ut-robotics/picr21-team-kobe/Kobe_Elektronics/Driver_footprint_w_desc.png

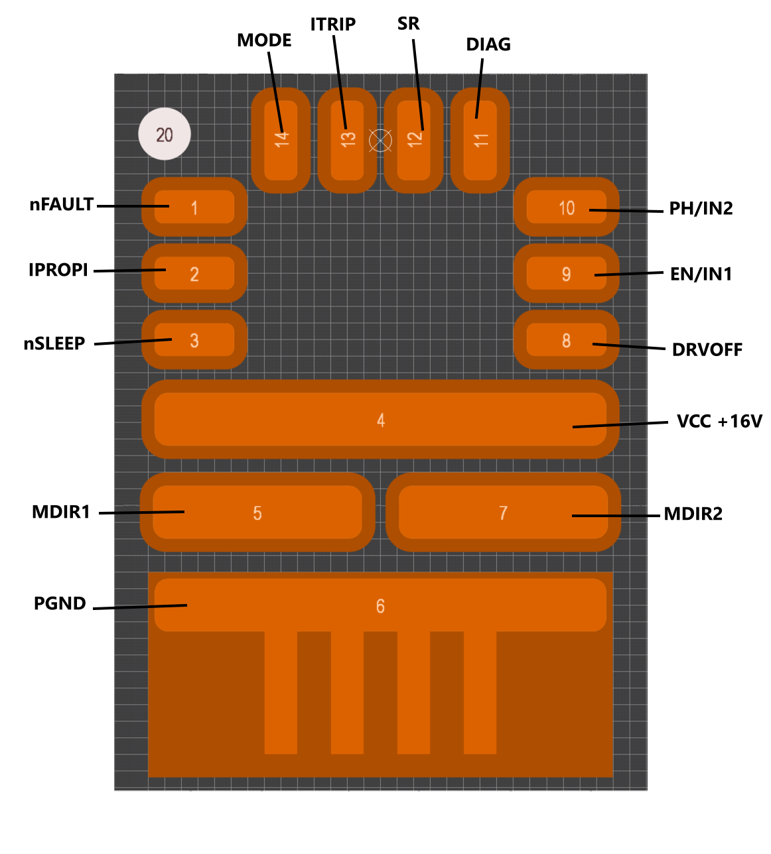
Kobe_Elektronics/Driver_footprint_w_desc.png
