ut-robotics/picr21-team-kobe/Kobe_Elektronics/BOM_PartType-Kobe_BasketballRobot.xlsx

Comment | Description | Designator | Quantity | Farnell | Mouser | TME
100nF |  | C1, C2, C3, C4, C5, C10, C12, C13, C14, C15, C16, C18, C19, C20, C21 | 15
10uF | Capacitor 1206 | C6, C7, C8, C17, C23, C25, C26, C27, C28 | 9
1uF |  | C9, C11, C22, C24 | 4
CM1223 | TVS diode, USB | D1 | 1 | 3607672 (https://uk.farnell.com/on-semiconductor/cm1223-02so/esd-protection-devices/dp/3607672) | 748-CM1223-02SO (https://eu.mouser.com/ProductDetail/onsemi/CM1223-02SO?qs=lLuKAerq7nnvVg3rEtIojA%3D%3D)
LED red |  | D2, D3, D4, D5 | 4
MicroUSB_K | microUSB port | J1 | 1
37D motor | Wheel motor | J2, J3, J4 | 3
ST-LINK | Programmer for microcontroller | J7 | 1 |  | 200-FTSH10501LDVK (https://eu.mouser.com/ProductDetail/Samtec/FTSH-105-01-L-DV-K?qs=%252B5JSS813miOqo3Vy%252BvhCFg%3D%3D)
Encoder | Encoder for motor | J8, J9, J10 | 3 |  |  | AMP-7-215079-4 (https://www.tme.eu/en/details/amp-7-215079-4/micro-match-connectors-1-27mm/te-connectivity/215079-4/)
Thrower | Thrower motor | J11 | 1 |  |  | AMP-7-215079-4 (https://www.tme.eu/en/details/amp-7-215079-4/micro-match-connectors-1-27mm/te-connectivity/215079-4/)
4,7k |  | R1, R3, R4, R7 | 4
3,3k |  | R2, R5, R6 | 3
100k |  | R9, R13, R17 | 3
BUK6Y10-30P | Reverse voltage protection | T1 | 1 | 3438512 (https://ie.farnell.com/nexperia/buk6y10-30px/mosfet-p-ch-30v-80a-lfpak56/dp/3438512) | 771-BUK6Y10-30PX (https://eu.mouser.com/ProductDetail/Nexperia/BUK6Y10-30PX?qs=vmHwEFxEFR9UKLhknfc3PQ%3D%3D)
DRV8243H-Q1 | Motor driver | U1, U2, U3 | 3 |  |  |  | DRV8243-Q1 (https://www.ti.com/product/DRV8243-Q1)
STM32G441 | Microcontroller | U4 | 1 | 3132405 (https://ee.farnell.com/stmicroelectronics/stm32g431kbt6/mcu-32bit-170mhz-lqfp-32/dp/3132405) | 511-STM32G431KBT6 (https://www.mouser.ee/ProductDetail/STMicroelectronics/STM32G431KBT6?qs=T3oQrply3y8teCTeNAFOLg%3D%3D)
MAX14930 | 4 channel isolator | U5, U8 | 2 | 3257451 (https://ie.farnell.com/maxim-integrated-products/max14930dase/digital-isolator-4ch-40-to-125deg/dp/3257451) | 700-MAX14930DASE+ (https://eu.mouser.com/ProductDetail/Maxim-Integrated/MAX14930DASE+?qs=AAveGqk956HveTQGChomNg%3D%3D)
NCP164 | TSOP-5 microcontroller voltage regulator | U6 | 1 | 3367831 (https://ee.farnell.com/on-semiconductor/ncp164csn330t1g/ldo-fixed-3-3v-0-3a-40-to-150deg/dp/3367831) | 863-NCP164CSN330T1G (https://eu.mouser.com/ProductDetail/onsemi/NCP164CSN330T1G?qs=xZ%2FP%252Ba9zWqbi%2FAyy5UtoRw%3D%3D)
NCV8730 | TSOP-5 Voltage regulator motor driver | U9 | 1 | 3463974 (https://il.farnell.com/on-semiconductor/ncv8730asn500t1g/ldo-fixed-5v-0-15a-40-to-125deg/dp/3463974) | 863-NCV8730ASN500T1G (https://eu.mouser.com/ProductDetail/onsemi/NCV8730ASN500T1G?qs=GedFDFLaBXHk1ABQHGw1TA%3D%3D)
