ut-robotics/picr21-team-kobe/(threads)

Thread 1 (2021-09-23):

[Mechanics] - sketches underdefined

Akustav, 2021-09-23:
Sketches for components are underdefined. This creates issues when you need to change model dimensions and the component can react in unexpected ways.
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
Can be changed to something like this without issues. It certainly is invalid
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

Also:
The warnings in components should not be ignored but fixed:
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

This feedback goes for all components you created.

erkiveevali, 2021-09-28:
Resolved the warnings, fixed underdefined sketches where I could find them.

Akustav, 2021-09-28:
Seems fine now.

Closed 2021-09-28.

Thread 2 (2021-09-23):

[Mechanics] - material thickness is wrong

Akustav, 2021-09-23:
The 5 mm material is in reality 4.8. All components should use this thickness instead of 5.0mm. If you want to use 3 mm PC then the thickness for that is 2.8mm.

erkiveevali, 2021-09-28:
Thrower components (sidewalls and ramps) are now 4.8mm thick. Motor spacer however needs to be 8mm thick for the motor to be positioned in the center of the thrower, so this needs to be 3D-printed I think.

Akustav, 2021-09-28:
Okay. Seems fine.

Closed 2021-09-28.

Thread 3 (2021-09-23):

[Mechanics] - spacers in thrower can be touched by ball

Akustav, 2021-09-23:
Spacers inside the thrower might be too close to the ramps outside edge and can collide with the ball
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

erkiveevali, 2021-09-28:
The spacers are only between the sidewalls and ramps and not in the wide gap in the center(where the ball would be pushed into the most). Is the ball really gonna be pushed into the thin (7.5mm) gap between on the sides. Also if the ball is compressed on the motor side as well, it won't reach to the spacers.

I could move the spacers further back but I'm afraid that the construction wouldnt be as strong then, if the screw holes are just a couple millimeters from the edge. Another solution would be to move the motor further to front a bit.

Is the gap between the ramps and motor OK right now? If I am gonna need to move components around a bit, then I can change these parameters as well if needed.

Akustav, 2021-09-28:
Okay, true.

Closed 2021-09-28.

Thread 4 (2021-09-23):

[Mechanics] - thrower cable hole seems too small

Akustav, 2021-09-23:
Is the hole for motor cables sized correctly to fit the cables through?

erkiveevali, 2021-09-28:
Made the hole a bit bigger so cables certainly fit through.

Closed 2021-09-28.

Thread 5 (2021-09-23):

[Mechanics] - inteference in the assembly

Akustav, 2021-09-23:
There are clipping parts in the assembly that should be looked at. I suspect there is additional interference around the circled areas on the picture. Usually, there should be no interference.
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

erkiveevali, 2021-09-28:
Since I changed the components and joints due to other issues then those interference problems should be resolved as well. Fusion  still shows some interference in the assembly, but I'm not entirely sure why.

Akustav, 2021-09-28:
I suggest checking how these 4 corners are cut in the actual model:

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

There might be some radiuses that are not accounted for in the design but are there due to milling

erkiveevali, 2021-09-30:
The top ones are fine, since the sides of the ramps arent touching the plate and the corners of the hole in the plate aren't sharp 90degree angles.
On the bottom plate however, the angles do have a small radius that isnt present on the model. I'd say I just file the corners on the bottom plate a bit, to make the ramps fit snugly right against the bottom plate. Thats because I'd like the ramps to be supported by the plate like that.

Akustav, 2021-09-30:
This issue is then OK. You can continue with the CAM

Closed 2021-09-30.

Thread 6 (2021-09-23):

[Mechanics] - robot height from the ground

Akustav, 2021-09-23:
How high should the robot be off the ground with its wheels? It is important as it affects how high the motor can be. If it is too high, the ball won't be pulled in and instead bounces off other parts of the chassis. This also allows tuning how low the ramp can be without damaging the carpet or disturbing the robots driving

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

erkiveevali, 2021-09-28:
The bottom plate is around 8mm off the ground right now. The thrower ramp extends 5.5mm from the bottom plate - there should be 2.5mm of clearance between the carpet and the thrower ramps.

Akustav, 2021-09-28:
Okay, if it is 8mm then everything seems fine.

Closed 2021-09-28.

Thread 7 (2021-10-07):

[Mechanics] - current feedrates too large

Akustav, 2021-10-07:
I think the current state of the mill does not allow for 1000mm/min feedrates. I would suggest at most 800mm. You can also reduce RPM to around 16000 in this case.

Closed 2021-10-07.

Thread 10 (2021-10-10):

with serial errors the connection is closed

Akustav, 2021-10-10:
https://github.com/ut-robotics/picr21-team-kobe/blob/46eb101d32f8b6000470f36c38c8d0c5126a2891/serialcomms.py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

With how this currently is the serial connection is shut down and no feedback is relayed to the program. It would be much preferred to throw an exception that can be handled and maybe the serial connection can be re-established.

Akustav, 2021-10-17:
The current solution currently prints an error, so you can see it in the log but it is unusable in the logic since the method itself does not throw an exception.
`raise Exception("some exception text")`
can be used for that.

Closed 2021-10-21.

Thread 12 (2021-10-10):

finding and driving to ball are separate files with alot of duplicate code

Akustav, 2021-10-10:
All tasks in programming are iterative and should not be considered as separate. Currently the code is structured so that every task is separate and isolated (Find_Detect.py and Find_Drive.py).

Maybe I am looking at wrong files but how things should be structured is that you have a file or collection of files that drive some kind of a state machine that does the decisions like finding balls, aiming, throwing, etc. This kind of structure allows for better logical separation and simplifies debugging since certain parts of code are responsible for well defined functionalities.

**NOTE: this is a example structure and should not be taken as pure gold. It illustrates how to write more maintainable code**

A example structure:
* robot_runner.py - main file containing the state machine and contains game logic/decision making components. Should not directly utilize low logic components like mainboard_communication.py but instead robot_driver.py. Same for camera.
* referee_module.py - module with methods for handling the web-socket data sent by the referee module.
* camera_module.py - base methods to fetch frames from the camera and to configure its parameters.
* image_processing.py - contains logic that handles vision, like getting ball/basket coordinates, has abstraction methods to simplify handling of visual data
* mainboard_communication.py - contains info on how to send and receive commands to/from the mainboard
* robot_driver.py - used as a abstraction layer between the mainboard_communication.py and robot_runner.py. Exposes methods to dictate how the robot should drive using omni-motion (speed, direction, rotation, etc), and to control the throwing mechanism.
* camera_calibration.py - uses the image processing.py and provides an UI to calibrate colors for the robot. Generates the configuration used by image_processing.py

Thread 17 (2021-10-10):

hardcoded frame width

Akustav, 2021-10-10:
https://github.com/ut-robotics/picr21-team-kobe/blob/46eb101d32f8b6000470f36c38c8d0c5126a2891/Find_Drive.py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

The way this is currently solved it is impossible to change camera resolution without extensive changes required in the driving logic. I would suggest having these sizes in a configuration file and rather use percentages than hardcoded constants unless they are based on constants, like speeds (m/s definition does not change, for example).

Akustav, 2021-10-17:
Seems better now, yeah

Closed 2021-10-17.

Thread 22 (2021-10-21):

[Mechanics] tweaks to the way rollers are held in by the wheel

Akustav, 2021-10-21:
I would suggest 3 changes to the wheel roller area.
1. Tighten tolerances to the shaft of the roller, you can leave around 0.1mm or so
2. Add more space to the roller area. This reduces roller resistance and dirt affects driving less. I would suggest 0.3-0.5mm per side for spacing
3. To counteract the larger spacing per roller you can add a conical support to where the shaft connects to the roller. This reduces roller wobble.

Summary picture:
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

Akustav, 2021-11-01:
OK now

Closed 2021-11-01.

Thread 24 (2021-10-21):

[Mechanics] - reduce size of fastener

Akustav, 2021-10-21:
I would reduce the size of the motor fastener piece. This makes your life easier since there is less material to remove.

An example of D=30mm vs D=25mm:

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

I think you can also make it shorter:

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

Akustav, 2021-11-01:
OK

Closed 2021-11-01.

Thread 29 (2021-11-06):

Refactor states to use enums and matcher

Akustav, 2021-11-06:
An example of how enums can be defined and used in the driving logic instead of a IF-ELSE block:

```
from enum import Enum
class State(Enum):
 FIND = 0
 DRIVE = 1
 AIM = 2
 THROW = 4
```

If you use python 10 you can also use this:
```
while True:
 ...
 match state:
  case FIND:
   ...
   continue
  case DRIVE:
   ...
   continue
  ...
```

Before python 10 you can utilize this example. It is limited in the sense that fall through is a pain

```
from enum import Enum

class State(Enum):
 FIND = 0
 DRIVE = 1
 AIM = 2
 THROW = 3

def handleFind(coordinates):
    print("finding_" + str(coordinates))

def handleDrive(coordinates):
    print("driving_" + str(coordinates))

ballData = ["someData"]

switcher={
    State.FIND: handleFind(ballData),
    State.DRIVE: handleDrive(ballData)
    }

# main loop that executes some logic
switcher.get(State.FIND)
switcher.get(State.DRIVE)
```

https://github.com/ut-robotics/picr21-team-kobe/blob/9f3d25f5802e43e8fc130219fb4fb0fc0b259346/Robot_runner.py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

capnarchie, 2021-11-07:
Is this the correct implementation?
https://github.com/ut-robotics/picr21-team-kobe/blob/f1049b4e73890cd247a7a22e3b0cb84c8893d68e/Robot_runner.py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
https://github.com/ut-robotics/picr21-team-kobe/blob/f1049b4e73890cd247a7a22e3b0cb84c8893d68e/Robot_runner.py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
https://github.com/ut-robotics/picr21-team-kobe/blob/f1049b4e73890cd247a7a22e3b0cb84c8893d68e/Robot_runner.py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

Although I don't see the real difference in this implementation, I'm still using if statements too, or did I misunderstand something?

Akustav, 2021-11-07:
I would use State.FIND instead of State(0) and so on.

This changes main point is to add structure to your code, there is a well-defined set of states with defined behavior in the match state.

You also make code less error prone. For example if you do a typo in the state name then code will run as normal. With enum objects and the state matcher.

The case `case _:` can be used to handle default cases. You would add an exception there, since it is not normal for the robot to run in an unknown state that might not have been implemented.

Closed 2021-11-24.

Thread 33 (2021-11-07):

Unify code style

Akustav, 2021-11-07:
https://github.com/ut-robotics/picr21-team-kobe/blob/77b2aa011ddafe7fa09fa254b48fecdce3873b44/Image_processing.py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

The coding style should be unified. Some methods are capitalized while others, for example in the remote controller code, are lower case.

capnarchie, 2021-11-29:
Is this a duplicate issue now? In any case coding style should be more unified now.

Closed 2021-12-04.

Thread 38 (2021-11-10):

Use 100mil grid on schematic

ReikoR, 2021-11-10:
All the component symbols should be aligned to 100mil grid, as it's the standard grid being used throughout the electronics schematics. Otherwise creating the schematic might be problematic.

On the image the grid has be changed to 100mil. Standard components can be placed on the grid, but the USB connector symbol can't be placed on the grid.

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

Closed 2021-11-13.

Thread 39 (2021-11-10):

Missing reference designators

ReikoR, 2021-11-10:
Encoder connectors don't have reference designators.

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

Closed 2021-11-13.

Thread 41 (2021-11-10):

Add input capacitor to voltage regulators

ReikoR, 2021-11-10:
Voltage regulators should have input capacitors. Also output capacitors should have higher values than 100 nF.

From [NCP164 datasheet](https://www.onsemi.com/pdf/datasheet/ncp164-d.pdf):

> **Input Decoupling (C<sub>IN</sub>)**
> It is recommended to connect at least 1 uF ceramic X5R or X7R capacitor between IN and GND pin of the device.

> **Output Decoupling (C<sub>OUT</sub>)**
> The device is designed to be stable with standard ceramics capacitors with values of 1 uF or greater.

ReikoR, 2021-11-13:
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

Both LDOs should have input and output capacitance higher than 100 nF. Datasheet recommends at least 1 µF.

Recommendations also from the [NCV8730 datasheet](https://www.onsemi.com/pdf/datasheet/ncv8730-d.pdf):

> **Input Capacitor Selection (C<sub>IN</sub>)**
> The value of the input capacitor should be 1 µF or greater (max. value is not limited).

> **Output Capacitor Selection (C<sub>OUT</sub>)**
> The LDO is designed to remain stable with output capacitor’s effective capacitance in range from 1 µF to 100 µF and ESR from 1 mΩ to 200 mΩ.

Closed 2021-11-15.

Thread 44 (2021-11-10):

Add bulk capacitors to motor driver VM pins

ReikoR, 2021-11-10:
Bulk capacitance is needed when driver's output current changes rapidly. Capacitors provide a low impedance source for that current.

Roughly 100 uF per driver should be enough. Using either ceramic or electrolytic or combination of both should work fine.

ReikoR, 2021-11-15:
47 uF capacitors are currently in 0603 package in the design. This is too large of a capacitance for 0603 capacitors.

I would recommend using 10 uF or 22 uF capacitors in 1206 package.

You can check the availability and prices for example from here:
https://www.mouser.ee/c/passive-components/capacitors/mlccs/multilayer-ceramic-capacitors-mlcc-smd-smt/

ReikoR, 2021-11-26:
47uF ceramic capacitors are too expensive.

Comparison for 100 units:
1. [47uF 25V 1210 X5R](https://www.mouser.ee/ProductDetail/Taiyo-Yuden/TMK325ABJ476MM-T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) = 0.544€
2. [22uF 25V 1206 X5R](https://www.mouser.ee/ProductDetail/Taiyo-Yuden/TMK316BBJ226ML-T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) = 0.2€ (2x 22uF = 0.4€)
3. [10uF 25V 1206 X5R](https://www.mouser.ee/ProductDetail/Samsung-Electro-Mechanics/CL31A106MAHNNNE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) = 0.063€ (5x 10uF = 0.315€)
4. [10uF 25V 0805 X5R](https://www.mouser.ee/ProductDetail/Samsung-Electro-Mechanics/CL21A106KAYNNNF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) = 0.059€ (5x 10uF = 0.265€)

It's recommended to use 10uF 1206 capacitors as those are already available in the lab. If board space is of concern, then we could maybe order 10uF 0805 capacitors.

Closed 2021-11-28.

Thread 45 (2021-11-10):

Some programmer connector pins are not connected

ReikoR, 2021-11-10:
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

VCC, GND and NRST pins should be connected for the programmer to work correctly.

ReikoR, 2021-11-13:
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

Programmer connector NRST pin should also be connected to MCU NRST pin. Programmer needs to be able to reset the MCU.

100 nF capacitor on NRST pin should be connected to MCU not the programmer connector.

Closed 2021-11-15.

Thread 46 (2021-11-10):

Each MCU VDD pin should have separate decoupling capacitors

ReikoR, 2021-11-10:
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

Recommendations from [STM32G441KB datasheet](https://www.st.com/resource/en/datasheet/stm32g441kb.pdf)
5.1.6 Power supply scheme
Figure 16. Power supply scheme
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

Closed 2021-11-13.

Thread 47 (2021-11-10):

Add capacitor to NRST pin

ReikoR, 2021-11-10:
Recommendations from [STM32G441KB datasheet](https://www.st.com/resource/en/datasheet/stm32g441kb.pdf)
5.3.15 NRST pin characteristics
Figure 27. Recommended NRST pin protection
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

Switch on the drawing is optional.

> 1\. The reset network protects the device against parasitic resets.
> 3\. The external capacitor on NRST must be placed as close as possible to the device.

ReikoR, 2021-11-13:
Capacitor should be connected to MCU not the programmer connector.

Closed 2021-11-15.

Thread 48 (2021-11-13):

No connector for thrower PWM

ReikoR, 2021-11-13:
It's also possible to find out that some signal is not connected to anything by using Project -> Validate:
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

Squiggly line is shown for the pin that is not connected to anything else:
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

Error on messages panel after running Validate:
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

You should also try to fix other errors and warnings.

ReikoR, 2021-11-15:
Current thrower ESCs have 4-pin micromatch connector with following pinout:
1. GND
2. PWM
3. NC
4. NC

I would recommend using the same micromatch connector.

ReikoR, 2021-11-26:
Pinout is still wrong.

Closed 2021-11-28.

Thread 50 (2021-11-13):

Some components don't need decoupling capacitors

ReikoR, 2021-11-13:
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

TVS diodes should not need a capacitor. Capacitor on USB connector's 5V pin should help absorb the ESD spikes in addition to the diode. TVS diodes should anyway be connected close to the connector to absorb the ESD spike before they can propagate to other components.

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

100 nF capacitor at the output of reverse voltage capacitor has probably little effect. It's better to connect 100 nF capacitor close to each VM pin.

Closed 2021-11-15.

Thread 54 (2021-11-21):

Don't route ground

ReikoR, 2021-11-21:
Use 4 layers and put GND polygons on internal layers. Connect component grounds with vias close to the pads. It's also ok to put vias inside pads when the board is going to be hand soldered.

ReikoR, 2021-11-26:
Each component should have separate via(s) close to the pad.

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

ReikoR, 2021-11-28:
There is no need to add extra vias for through hole pads as the pads work the same way as vias:
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

Also GND and PGND should be on both internal layers. Layer 2 grounds will be reference for layer 1 signals and layer 3 grounds will be reference for layer 4 signals.

ReikoR, 2021-11-29:
There are still unnecessary GND vias and tracks. Try to keep vias close to the components.

Some examples:
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

ReikoR, 2021-11-29:
Reminder from comment before:

> Also GND and PGND should be on both internal layers. Layer 2 grounds will be reference for layer 1 signals and layer 3 grounds will be reference for layer 4 signals.

Both internal layers should have both GND and PGND polygons. For signal integrity it's important to have reference plane close to the signal and power tracks/polygons.

Closed 2021-11-30.

Thread 55 (2021-11-21):

Incorrect micromatch connector footprint

ReikoR, 2021-11-21:
Dimensions between plated holes are wrong.
There should additional non-plated hole for polarization pin.

From the [catalog](https://www.te.com/commerce/DocumentDelivery/DDEController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):
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

Also annular ring is too small for plated holes.

From [JLCPCB capabilites](https://jlcpcb.com/capabilities/Capabilities):
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

I would recommend 1.3mm diameter pads with 0.8mm holes for easier soldering

ReikoR, 2021-11-26:
Some space needs to be left for micromatch plugs.

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

Plug dimensions can be found on the same [catalog pages](https://www.te.com/commerce/DocumentDelivery/DDEController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).

Closed 2021-11-28.

Thread 56 (2021-11-21):

Move USB ESD protection IC closer to USB connector

ReikoR, 2021-11-21:
Having ESD protection closer to the connector helps to prevent ESD pulses from travelling to other components.

Closed 2021-11-26.

Thread 59 (2021-11-21):

Improve DRV8243 footprint

ReikoR, 2021-11-21:
Try to more closely follow the recommendations in the [datasheet](https://www.ti.com/lit/ds/symlink/drv8243-q1.pdf) for GND pad:
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

It's possible to use fills to create custom pad shapes:
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

Example that should probably work:
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

1. SMD pad with 0 mm solder mask expansion:
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

2. Fill with 0 mm solder mask expansion:
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

3. Fill with no solder mask expansion:
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

ReikoR, 2021-11-28:
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

GND pad does not really follow the recommendations, but might work. Soldering might be harder with big rectangular pad.

Closed 2021-11-28.

Thread 60 (2021-11-21):

Use wider tracks or polygons for higher currents

ReikoR, 2021-11-21:
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

Narrow tracks might heat up when carrying higher currents.

You can try trace width calculators to get an idea of the current carrying abilities of copper traces.

Example from Saturn PCB Design Toolkit:
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

Closed 2021-11-28.

Thread 61 (2021-11-26):

Avoid overlapping schematic objects

ReikoR, 2021-11-26:
Some of the problems:

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

Wires are overlapping pins, causing the dots to appear:
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

ReikoR, 2021-11-28:
Still some overlap left on the schematic:

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

Closed 2021-11-29.

Thread 64 (2021-11-26):

Improve reference designator placement on PCB

ReikoR, 2021-11-26:
Avoid overlapping and placing text/overlay on the pads.

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

ReikoR, 2021-11-28:
Silkscreen/overlay won't work if it's on the pads.
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

ReikoR, 2021-11-29:
Text still on a pad:
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

Designators on the PCB are more useful if not placed under components.

Some examples:
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

ReikoR, 2021-11-30:
Some designators should or could be closer to the components.

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

Some designators could be rotated to make it easier to understand which component they belong to.

Before:
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

After:
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

It's better to have designator rotated the same way as the component.

Closed 2021-11-30.

Thread 66 (2021-11-26):

[Mechanics] - where will the electronics be

Akustav, 2021-11-26:
Currently there is no  electronics installed on the model.

erkiveevali, 2021-11-29:
Added a quick model of the new PCB to the robot. Other electronics will be mounted to the bottom plate as well, to simplify disassembly.

erkiveevali, 2021-12-03:
Yes, checked the placement of connectors on the PCB

Akustav, 2021-12-04:
OK

Closed 2021-12-04.

Thread 67 (2021-11-26):

[Mechanics] - what stops balls from going into the chassis?

Akustav, 2021-11-26:
You should have either a skirt or a frame to stop balls from getting into the chassis.

erkiveevali, 2021-11-30:
Added a frame to stop the balls from getting into the robot.

Closed 2021-11-30.

Thread 68 (2021-11-26):

[Mechanics] - simplify top plate mounting

Akustav, 2021-11-26:
I suggest removing some tabs for  the top plate mounting and instead just use screws. This increases ease-of-assembly while not reducing robustness.

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

Akustav, 2021-11-30:
Some mis-alignment on the top holes:
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

Closed 2021-11-30.

Thread 69 (2021-11-26):

[Mechanics] - some interferences

Akustav, 2021-11-26:
Some interference in the models. Would be good if they are solved.

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

erkiveevali, 2021-11-30:
There were some actual interference between the wheels and bottom plate, resolved that. Other interferences between various joints arent supposed to be there because the dimensions of the parts seem correct. And the interferences in the NUC and camera assemblies can be ignored as well.

Closed 2021-11-30.

Thread 70 (2021-11-26):

[Mechanics] - hole misalignment in camera mount/battery holder

Akustav, 2021-11-26:
Some misalignment here:
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

erkiveevali, 2021-11-29:
Misalignment fixed now. Was probably caused by adding the rounded corner, which caused the hole to shift.

Closed 2021-11-30.

Thread 71 (2021-11-26):

[Mechanics] - computer impossible to remove unless whole robot is dissasebled

Akustav, 2021-11-26:
Currently the computer is fastened in such a way that the screws are very inaccessible. The whole top needs to be disassembled to remove it. This is intentional?

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

erkiveevali, 2021-11-29:
The computer can be removed with the plate its mounted to. The screws that hold the plate are accessible from the top and nothing else is holding that plate to the robot. There arent a lot of good ways to make the screws for the NUC itselt accessible unless I mount it upright or upside-down.

Closed 2021-11-30.

Thread 72 (2021-11-26):

[Mechanics] - check internal corners of assemblies

Akustav, 2021-11-26:
Some corners are missing cutouts and need to be manually touched up if not fixed.

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

erkiveevali, 2021-11-29:
Fixed the corners on the picture, didnt find any similar issues elsewhere

Akustav, 2021-11-30:
New issue appeared with the latch:
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

erkiveevali, 2021-12-01:
Fixed the issue with the latch hole as well.

Closed 2021-12-04.

Thread 73 (2021-11-26):

[Mechanics] - thrower only fastened from the top

Akustav, 2021-11-26:
This is intended? Would a more rigid connection increase robustness?

erkiveevali, 2021-11-29:
Was not intended. The thrower sideplates had holes both on top and bottom but the bottom plate didnt. Fixed it now.

Thread 74 (2021-11-26):

[Mechanics] - what force holds batteries in the box

Akustav, 2021-11-26:
Question in the title.

erkiveevali, 2021-11-29:
Friction, mainly. Added a fancy latch? to keep the batteries in there as well. A simple stopper made from a screw and a spacer can be added (as a hack) to the front of the battery compartment if the batteries are really that loose in there. But based to my measurements they should fit snugly in there without any fasteners.

Akustav, 2021-11-30:
Would like to see the batteries in the box as well, then it is better to see how they are fastened and that they can not move

erkiveevali, 2021-12-02:
Batteries are now in the box

Akustav, 2021-12-04:
Can't batteries slip out like this? Maybe you can add a bolt head to the top or bottom to act as a stopper
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

erkiveevali, 2021-12-06:
Added stoppers to the front as well

Closed 2021-12-07.

Thread 75 (2021-11-26):

[Mechanics] - screw heads interfere with batteries

Akustav, 2021-11-26:
Do normal screw heads interfere with batteries that will be pushed into the box.

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

erkiveevali, 2021-11-29:
Yes they probably will, modified those screwholes (and also the ones that hold the NUC itself) to use countersunk screws instead.

Thread 77 (2021-11-26):

Use colors to identify side?

Akustav, 2021-11-26:
https://github.com/ut-robotics/picr21-team-kobe/blob/86b1d56523d720cfc33aebd9783ef87131fed20b/Robot_runner.py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

Color.BLUE and Color.MAGENTA are clearer than a boolean flag.

capnarchie, 2021-11-29:
done

Akustav, 2021-12-04:
I currently do not see it as being done. What did you change?

capnarchie, 2021-12-07:
Reverted the implementation before the competition due to it not working, but now it works.

Closed 2021-12-11.

Thread 80 (2021-11-26):

Use relative numbers based on frame size instead of constants

Akustav, 2021-11-26:
https://github.com/ut-robotics/picr21-team-kobe/blob/86b1d56523d720cfc33aebd9783ef87131fed20b/Robot_runner.py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

This is suggested to avoid issues with different resolutions.

capnarchie, 2021-11-29:
done

Akustav, 2021-12-04:
You used:

https://github.com/ut-robotics/picr21-team-kobe/blob/34579003f884aa876f4a892da02aef7702d666d4/Robot_runner.py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

This is basically the same thing. I suggest using percentages, like:

`state_data.ball_y > Camera.camera_y * 0,88 (=422)`

You can exclude` Camera.camera_y + 20` since it is impossible for the ball to be outside the frame.

capnarchie, 2021-12-07:
Changed hardcoded resolution dependencies to depend on percentages of resolution instead.

Closed 2021-12-11.

Thread 82 (2021-11-26):

Method name non-uniform

Akustav, 2021-11-26:
https://github.com/ut-robotics/picr21-team-kobe/blob/86b1d56523d720cfc33aebd9783ef87131fed20b/image_processor.py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

Format method names to be in one style. Currently you use snake case and a type of camel case.

capnarchie, 2021-11-29:
should be more PEP8-like now

Closed 2021-12-11.

Thread 83 (2021-11-26):

Check area instead of 1 pixel

Akustav, 2021-11-26:
https://github.com/ut-robotics/picr21-team-kobe/blob/86b1d56523d720cfc33aebd9783ef87131fed20b/image_processor.py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

Instead of sampling one point, sample a area to get a less noisy result and increase accuracy.

capnarchie, 2021-11-29:
Done although accuracy is pretty much same for both except for longer distance.

Akustav, 2021-12-04:
Accuracy contains of both direction and speed. Is the aim direction good/bad? Overall I would check the stability of the measurement when the robot aims at a static object.

capnarchie, 2021-12-07:
Well it seems good enough that I can not differentiate between the two, so I guess it's working as intended.

Akustav, 2021-12-11:
One thing you can change for robustness is in case the range gets an out of bounds exception you can fallback to the one-pixel solution. If you do not want to double-check the ranges:

https://github.com/ut-robotics/picr21-team-kobe/blob/1c09a2ff8e201bfb6875c36d273c914e2959c723/image_processor.py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

Closed 2022-01-25.

Thread 85 (2021-11-28):

How will the mainboard be attached to the robot?

ReikoR, 2021-11-28:
There are no holes for attaching the board. Is there some other way for attaching the board?

ReikoR, 2021-11-29:
Current hole placement might work if countersunk screws are used, but holes are quite close to the components and pads.

I added circles around current holes with typical M3 bolt head diameter (5.5 mm).

Suggestions:
1. 2 holes would be enough.
2. Motor driver output pads could be made smaller.
3. 1 hole can be moved to the top left corner if components currently located there are moved to the left.

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

ReikoR, 2021-11-30:
It might be easier to add holes in the mechanical design if they were the same distance away from the corner.

Current left hole:
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

Current right hole:
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

3mm away from the corner in both directions would be a nice round number.

Closed 2021-11-30.

Thread 88 (2021-11-30):

[Mechanics] - Wheel holder bottom plate tab spacing off

Akustav, 2021-11-30:
The spacing should be 60 but for you it is 58,966. This creates some interference issues:
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

erkiveevali, 2021-12-03:
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
The dimensions on the sketch are correct, and I am using circular pattern to create 3 identical mounts. Im not sure where this weird number 59.966 comes from

Akustav, 2021-12-04:
The issue comes from the fact that  this line is not horisontally/vertically aligned. So it is at an angle and that creates a shift
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

erkiveevali, 2021-12-06:
All the design issues should be resolved now.

Closed 2021-12-07.

Thread 89 (2021-11-30):

[Mechanics] - add spacer for thrower rigidity

Akustav, 2021-11-30:
Since the thrower motor is fastened on one side I would add a spacer there to add rigidity to the thrower:

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

erkiveevali, 2021-12-01:
Added the spacer. Since its 44mm in length I will probably have to combine the length from multiple spacers. But should be possible.

Closed 2021-12-04.

Thread 90 (2021-12-07):

[Mechanics] - potential recreation of issue with thrower

Akustav, 2021-12-07:
If I remember correctly there is an issue with your current thrower that does not center the ball to well. When the ball rolls into the robot depending on which side it hits first, the ball gets grabbed and thrown differently. The areas in question:
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

I would discuss it with your programmers. One solution would be to move the thrower sidewalls closer in the front or move the motor back a little so the ball has some time to calm down before it is pulled into the thrower motor.

I think the thrower can be moved at least 2 cm inwards or even more, when you shorten the small ramp height.

erkiveevali, 2021-12-08:
Discussed the issue with Uku and we think that the issue on the old robot is mostly caused by the fact that the thrower sidewalls (especially one of them) dont fit the bottom plate that well. The cause of that problem is the fact we needed to modify the parts after milling to get them to fit at all. The whole test thrower moved to the front and created those corners that interfere with the ball. Although I cut the interfering corners, the current solution isnt ideal at the moment. As long as the new parts fit together like do in the model, that shouldnt be as big of an issue as it is now.

Moving the thrower inwards could yield better results in giving the ball time to calm down but it also means the robot has to move "blindly" forward more for the ball to reach the motor. So that could cause other problems.

Also moving the thrower inwards as much as 2cm will take but most of the free space behind the thrower (which was initially meant for motor wiring etc to fit into) leaving very little room inside the robot.

So I am not against moving the thrower inwards but I am not sure how much better results that would give overall

Akustav, 2021-12-08:
Yeah, I agree that it is a tradeoff and your decision in the end. Some things to consider:

As for moving the thrower inside, I also took into account that the ramp can be slimmed down and moved without much effort. Size of cabling on the motors is quite minimal, in my opinion. As for the blindly part the robot aims towards the basket at all times so it should not affect accuracy when the visual on the ball is lost. Overall I would try to achieve as robust a physical design as possible to allow for maximum accuracy. Every missed shot costs a lot of time and gives opponents an additional oppurtunity.

erkiveevali, 2021-12-08:
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
Was able to move the motor inside 11mm without redoing the ramps or thrower sides. Hopefully its better that way.

Akustav, 2021-12-08:
I would add something like this as well:

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

It strengthens the ramp again and also supports it by resting the piece on the top and bottom plate

erkiveevali, 2021-12-08:
Reinforced the ramps as described on the picture

Closed 2021-12-08.

Thread 92 (2021-12-07):

[Mechanics] - add some more spacing between components

Akustav, 2021-12-07:
I would increase the spacing between the components a little, this helps avoid pieces flying out of the plate when milled. Examples of close calls:

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

erkiveevali, 2021-12-08:
Increased spacing between components from 6.35mm to 10mm

Closed 2021-12-08.

Thread 93 (2021-12-11):

Avoid being too close to basket?

Akustav, 2021-12-11:
Does this line of code avoid the basket?

https://github.com/ut-robotics/picr21-team-kobe/blob/1c09a2ff8e201bfb6875c36d273c914e2959c723/robot_runner.py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

I would not use the area and instead use the bottom of the bounding box. You can compare it to the Y of the camera. If it is more than a certain range, like 0.9*Y, you are too close. Area is not as reliable since threshholding can be iffy and also if the basket is in the edge of the frame it has far less area.

Closed 2022-01-25.

Thread 98 (2022-01-25):

Wrong product codes for microcontroller in BOM

ReikoR, 2022-01-25:
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

Closed 2022-01-26.
