ut-robotics/picr21-team-kobe/Kobe_Elektronics/Kobe_schematic.PDF

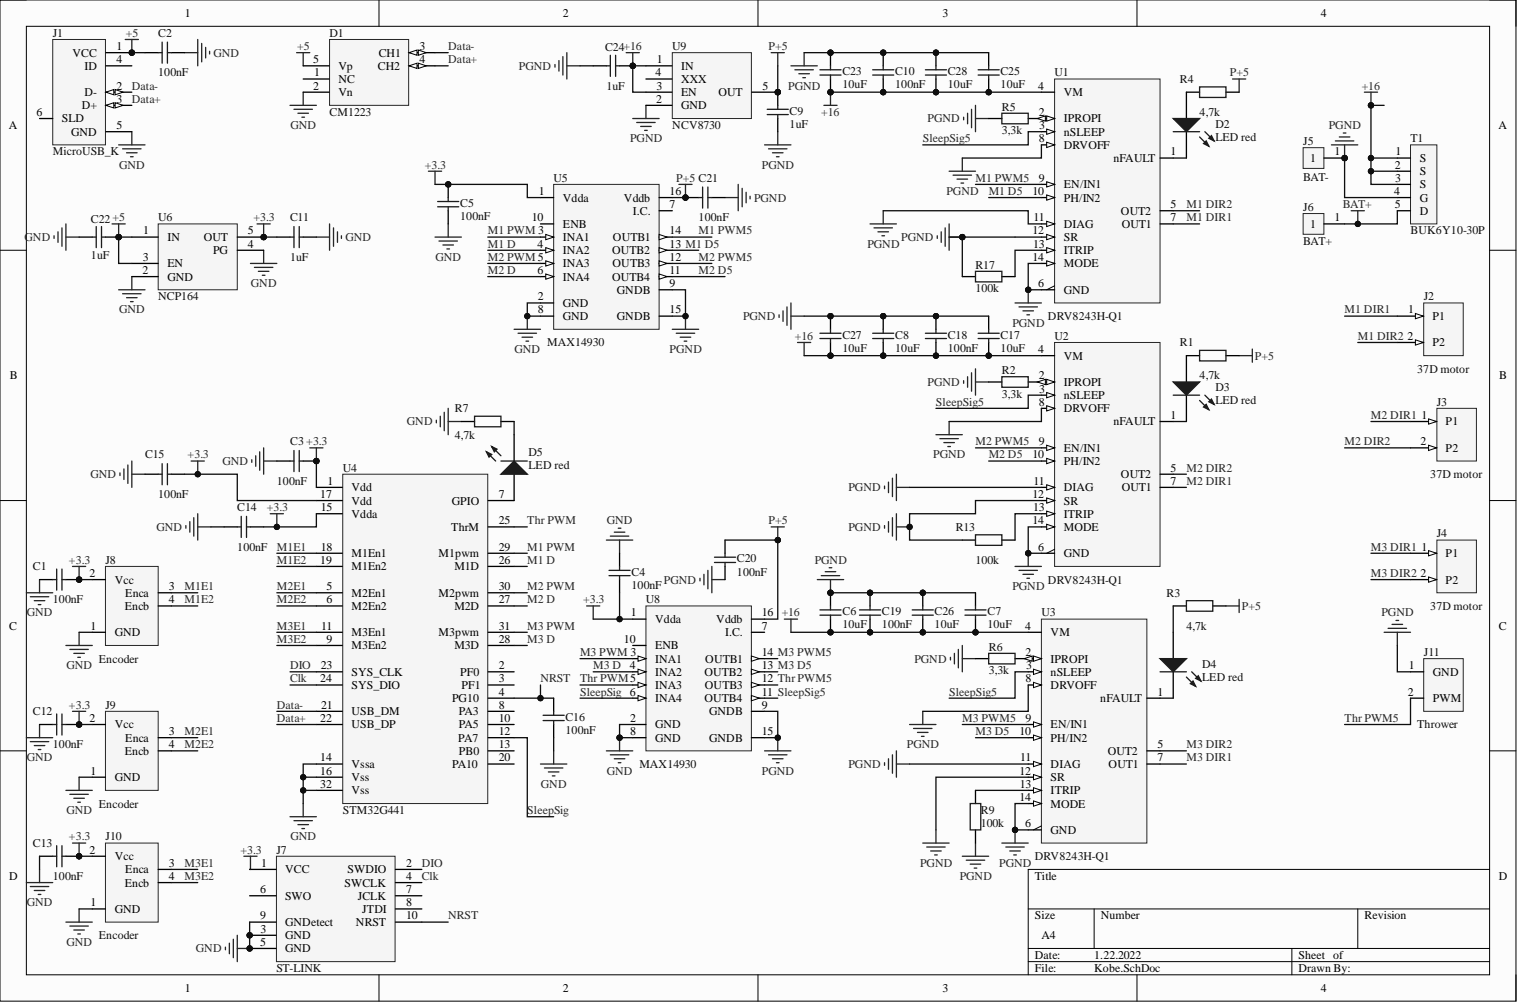
[picture p3: page 1]

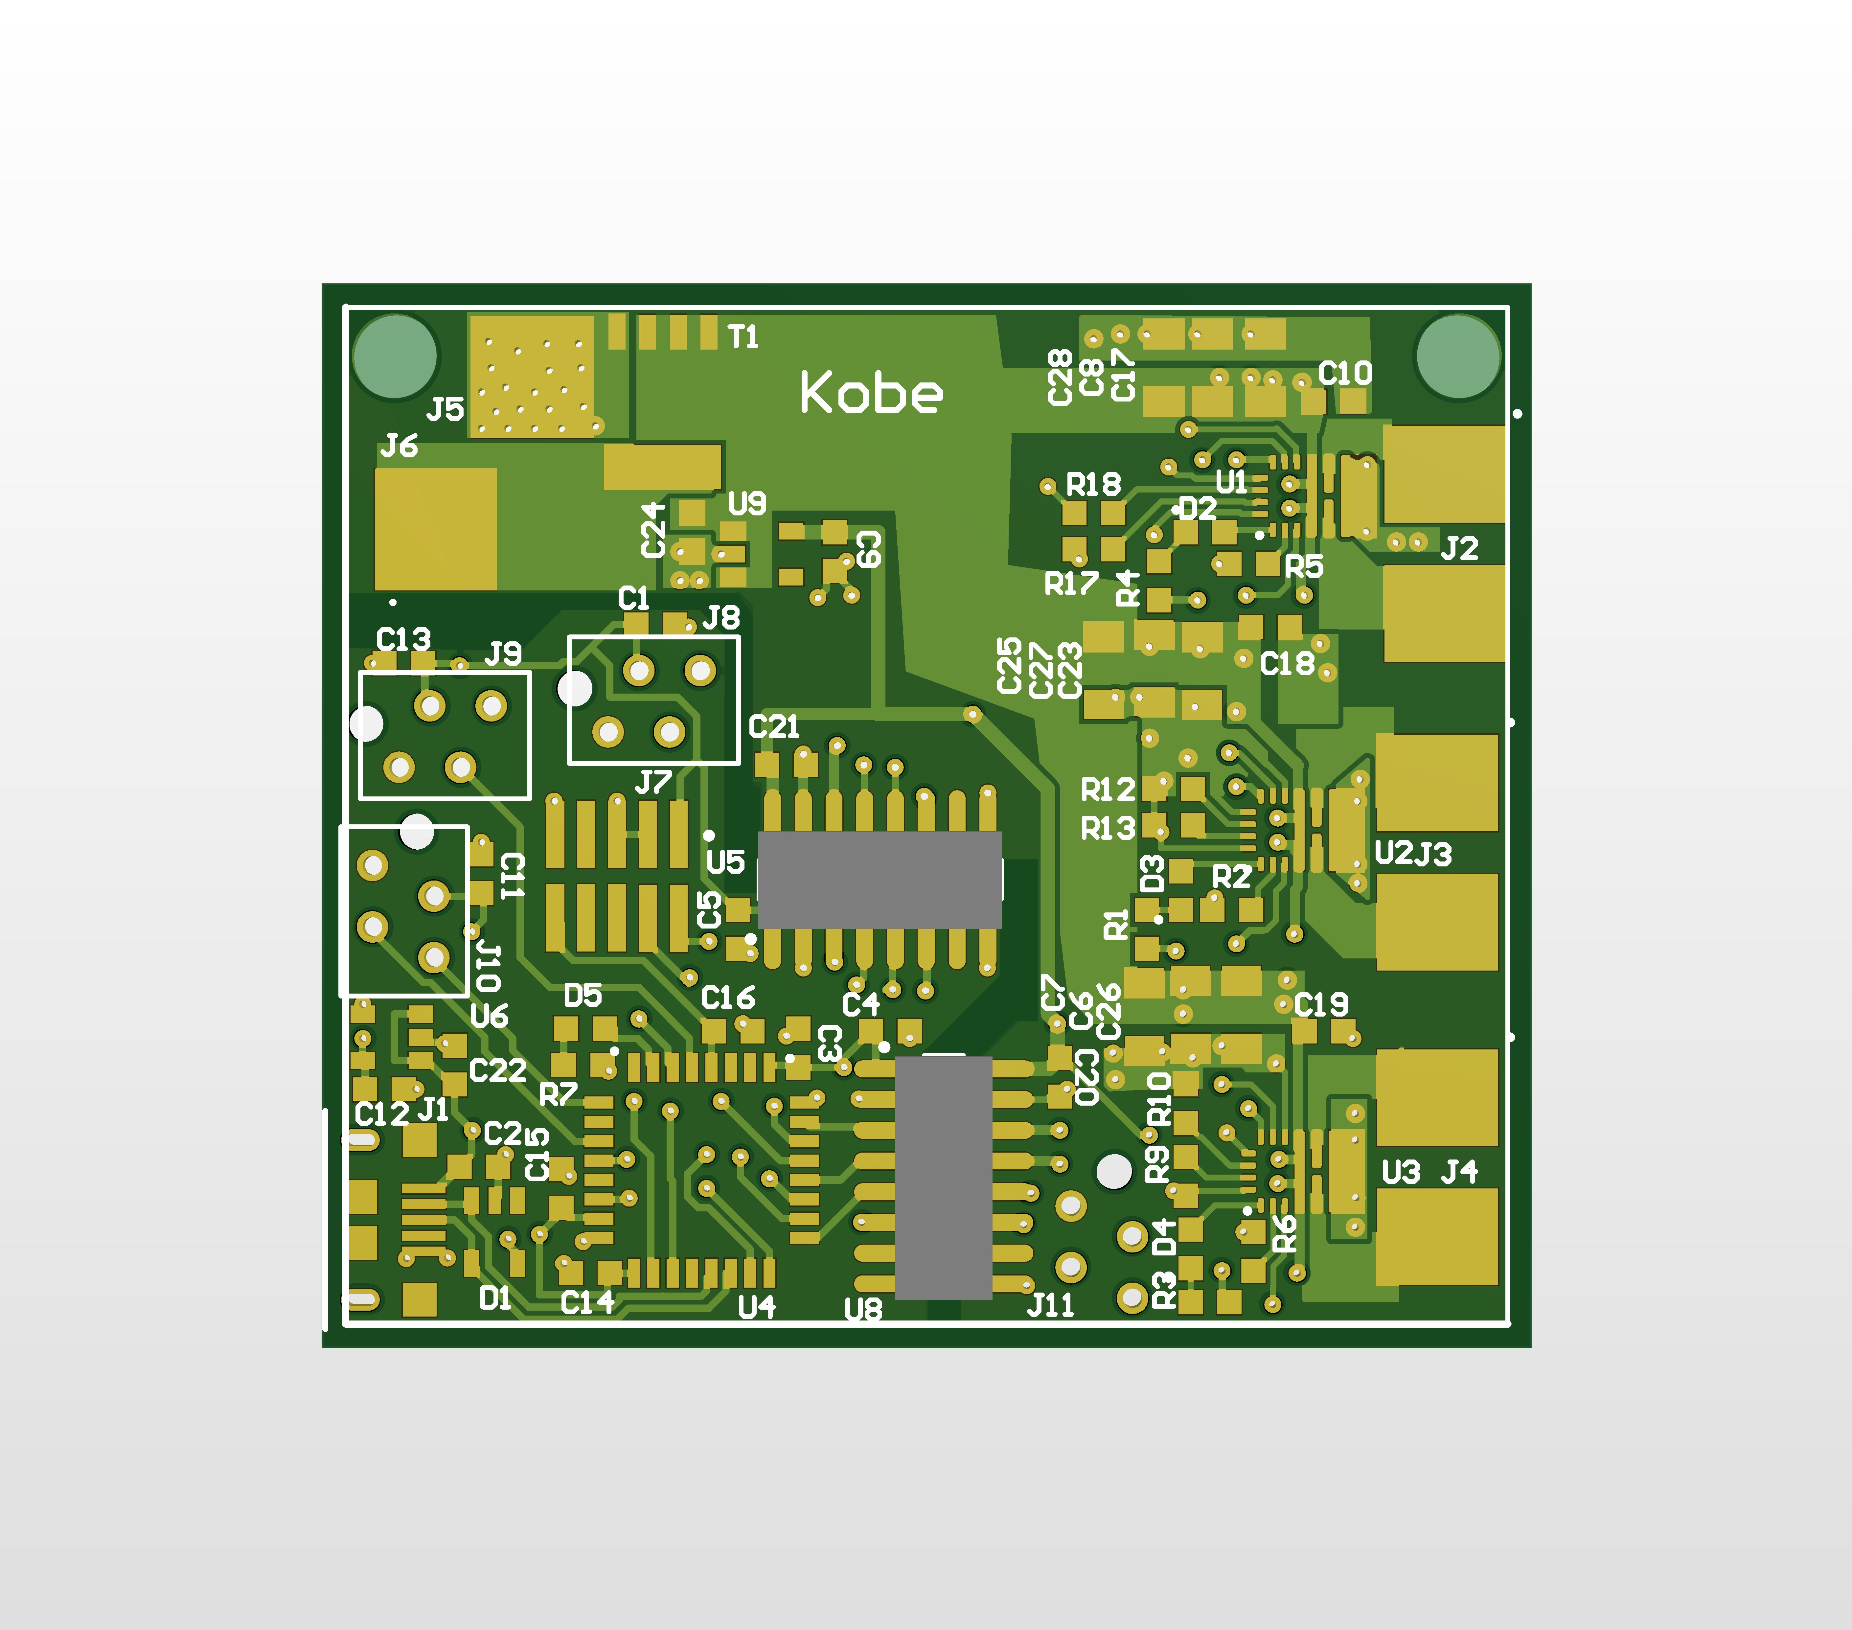
[picture p4: page 2]
