ut-robotics/picr21-team-kobe/Kobe_Elektronics/Kobe_Gerber_Files/Fabrication.PDF

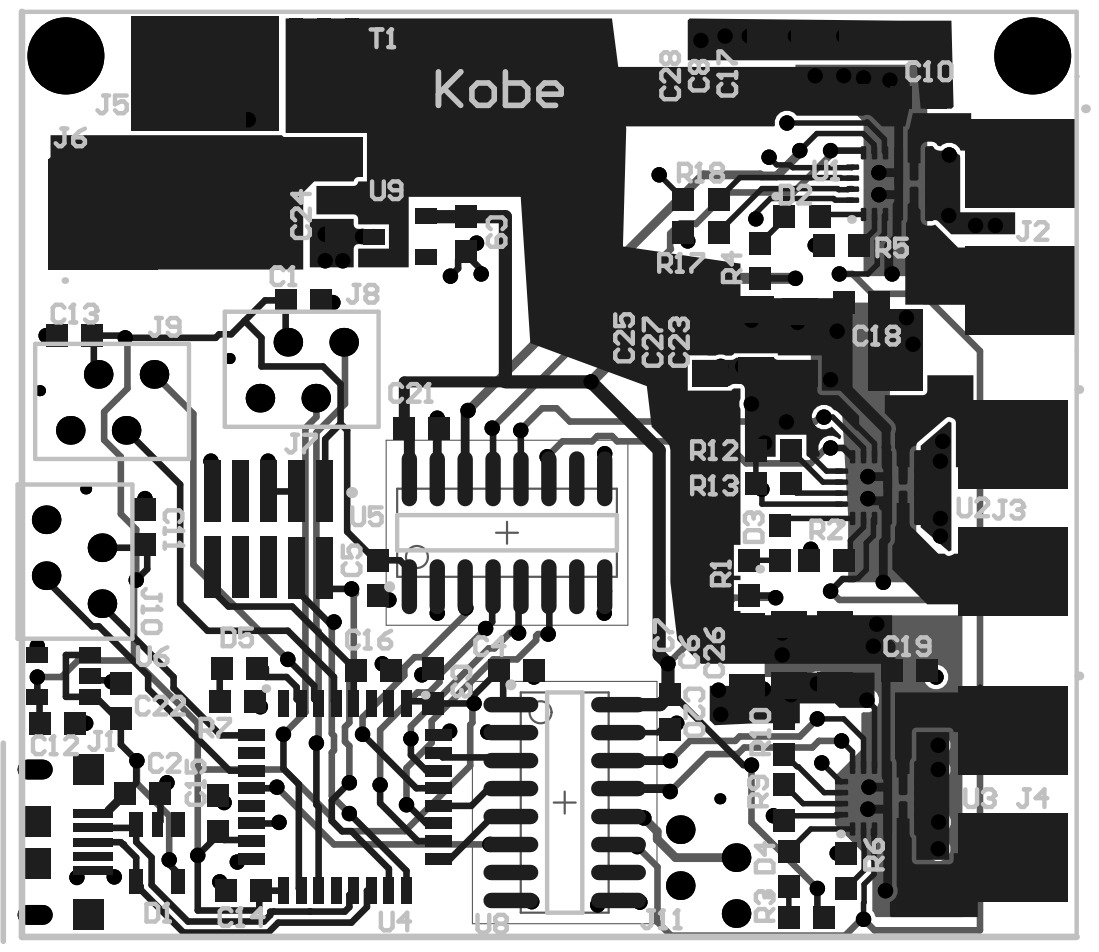
[picture p5: page 1]
