ut-robotics/picr21-team-kobe/keyboard_controller.py

from ctypes.wintypes import tagRECT
import cv2
import camera_config
import image_processor as ip
import movement
from color import Color

camera = camera_config.Config()
target = Color.MAGENTA
processor = ip.ProcessFrames(camera, target)


def keyboard_control():
    cv2.namedWindow("Controller")
    moving_speed = 60
    throwing_speed = 1100
    while True:
        count, y, x, center_x, center_y, basket_distance, floor_area, out_of_field, basket_size, opponent_basket_x, opponent_basket_bottom_y, basket_bottom_y, avoid_collision, turn_left, turn_right = processor.process_frame(
                align_frame=True)
        #print("distance", basket_distance * 100)
        #move(0, throwing_speed, 0)

        key = cv2.waitKey(1) & 0xFF
        if key == ord("w"):
            print("Moving forward.")
            movement.move_omni(0, moving_speed, 0,0)
        if key == ord("d"):
            print("Moving right.")
            movement.move_omni(-moving_speed, 0, 0,0)
        if key == ord("s"):
            print("Moving backwards.")
            movement.move_omni(0, -moving_speed, 0,0)
        if key == ord("a"):
            print("Moving left.")
            movement.move_omni(moving_speed, 0, 0,0)
        if key == ord("e"):
            print("Spinning right.")
            movement.move_omni(0, 0, moving_speed, 1800)
        if key == ord("q"):
            print("Spinning left.")
            movement.move_omni(0, 0, -moving_speed, 1800)
        if key == ord("t"):
            print("Throwing.")
            movement.move_omni(0, 0, 0, 1200)
        if key == ord("c"):
            print("Stopping.")
            movement.stop()
        if key == ord("x"):
            print("Shutting down.")
            movement.stop()
            break


keyboard_control()

cv2.destroyAllWindows()
