ut-robotics/picr21-team-kobe/Kobe_Elektronics/KobeMotorTester/KobeMotorTester.ioc

Mcu.UserName=STM32G441KBTx
PA0.Signal=S_TIM2_CH1
PA1.Signal=S_TIM2_CH2
PA11.Signal=USB_DM
PA12.Signal=USB_DP
PA13.Signal=SYS_JTMS-SWDIO
PA14.Signal=SYS_JTCK-SWCLK
PA15.Signal=S_TIM8_CH1
PA2.GPIO_Label=LED
PA2.Signal=GPIO_Output
PA4.Signal=S_TIM3_CH2
PA6.Signal=S_TIM3_CH1
PA7.Signal=S_TIM17_CH1
PA8.Signal=S_TIM1_CH1
PA9.Signal=S_TIM1_CH2
PB3.GPIO_Label=M1_D
PB3.Signal=GPIO_Output
PB4.GPIO_Label=M2_D
PB4.Signal=GPIO_Output
PB5.GPIO_Label=M3_D
PB5.Signal=GPIO_Output
PB6.Signal=S_TIM4_CH1
PB7.Signal=S_TIM4_CH2
PB8-BOOT0.Signal=S_TIM4_CH3
