ut-robotics/picr21-team-kobe/Kobe_Elektronics/KobeMotorTester/Core/Src/main.c

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
/* Includes ------------------------------------------------------------------*/
#include "main.h"
#include "usb_device.h"

/* USER CODE BEGIN Includes */

#include "usbd_cdc_if.h"

/* USER CODE END Includes */

TIM_HandleTypeDef htim1;
TIM_HandleTypeDef htim2;
TIM_HandleTypeDef htim3;
TIM_HandleTypeDef htim4;
TIM_HandleTypeDef htim6;
TIM_HandleTypeDef htim8;
TIM_HandleTypeDef htim17;
DMA_HandleTypeDef hdma_tim8_ch1;

DMA_HandleTypeDef hdma_dma_generator0;
void SystemClock_Config(void);
static void MX_GPIO_Init(void);
static void MX_DMA_Init(void);
static void MX_TIM2_Init(void);
static void MX_TIM3_Init(void);
static void MX_TIM1_Init(void);
static void MX_TIM4_Init(void);
static void MX_TIM8_Init(void);
static void MX_TIM6_Init(void);
static void MX_TIM17_Init(void);
/* USER CODE BEGIN 0 */

typedef struct Command { // (1)
  int16_t speed1;
  int16_t speed2;
  int16_t speed3;
  uint16_t throwerSpeed;
  uint16_t delimiter; // (2)
} Command;

typedef struct Feedback { // (3)
  int16_t speed1;
  int16_t speed2;
  int16_t speed3;
  uint16_t delimiter;
} Feedback;

typedef struct MotorControl {
	int16_t speed;
	int16_t position;
	int32_t integraal;
	int16_t p_gain;
	int16_t i_gain;
	int32_t newspeed;
	int16_t positionChange;
} MotorControl;

MotorControl motor1Control = {
	  .speed = 0,
	  .position = 0,
	  .integraal = 0,
	  .p_gain = 3000,
	  .i_gain = 675,
	  .newspeed = 0,
	  .positionChange = 0
};


MotorControl motor2Control = {
	  .speed = 0,
	  .position = 0,
	  .integraal = 0,
	  .p_gain = 3000,
	  .i_gain = 675,
	  .newspeed = 0,
	  .positionChange = 0
};

MotorControl motor3Control = {
	  .speed = 0,
	  .position = 0,
	  .integraal = 0,
	  .p_gain = 3000,
	  .i_gain = 675,
	  .newspeed = 0,
	  .positionChange = 0
};

Command command = {.speed1 = 0, .speed2 = 0, .speed3 = 0, .throwerSpeed = 0, .delimiter = 0}; // (4)
volatile uint8_t isCommandReceived = 0; // (5)
volatile uint8_t driverReset = 0;
uint16_t timer = 0;
uint16_t enable_pid = 0;
Feedback feedback = { // (1)
	      .speed1 = 0,
	      .speed2 = 0,
	      .speed3 = 0,
	      .delimiter = 0xAAAA
	  };;

int32_t clamp(int32_t value, int32_t minValue, int32_t maxValue) {
	if (value > maxValue) {
		return maxValue;
	}

	if (value < minValue) {
		return minValue;
	}
	return value;
}


void CDC_On_Receive(uint8_t* buffer, uint32_t* length) { // (6)
	if (*length == sizeof(Command)) { // (7)
		memcpy(&command, buffer, sizeof(Command)); // (8)

		if (command.delimiter == 0xAAAA) { // (9)
			isCommandReceived = 1;
		}
		if (command.delimiter == 0xBBBB) { // (9)
	  		driverReset = 1;
		}
	}
}

int32_t PIDcontrol(MotorControl* control, int16_t position){
	control->positionChange = position - control->position; //Lahutab vana positsiooni, et saada kiiruse
	control->position = position; //Salvestab asendi struktuuri
	int32_t error = control->speed -control->positionChange; //Kui suur on erinevus kiiruste vahel
	control->integraal += error;

	return control->p_gain * error + control->i_gain * control->integraal;
}

uint16_t pwmData[20];

void Thrower_Send (uint16_t command){
	// compute checksum

	uint16_t packet = (command << 1) | 0;

	HAL_TIM_PWM_Stop_DMA(&htim8, TIM_CHANNEL_1);
	int csum = 0;
	int csum_data = packet;
	for (int i = 0; i < 3; i++) {
		csum ^=  csum_data;   // xor data by nibbles
		csum_data >>= 4;
	}
	csum &= 0xf;
	// append checksum
	packet = (packet << 4) | csum;
	
	
	int counter = 0;
	for (int i=15; i>=0; i--)
	{
		if (packet & (1<<i)){
			pwmData[counter] = 798;
		}
		else{
			pwmData[counter] = 399;
		}
		counter++;
	}

	for (int i=19; i>=16; i--){
		pwmData[i] = 0;
	}
	HAL_TIM_PWM_Start_DMA(&htim8, TIM_CHANNEL_1, (uint32_t *)pwmData, 20);
}


void HAL_TIM_PeriodElapsedCallback(TIM_HandleTypeDef *htim6) {
	if (enable_pid == 1){

		int16_t position;
		position = (int16_t)TIM1->CNT;
		int32_t pwmValue = PIDcontrol(&motor1Control, position);
		HAL_GPIO_WritePin(M1_D_GPIO_Port, M1_D_Pin, (pwmValue < 0) ? GPIO_PIN_SET : GPIO_PIN_RESET);
		TIM4->CCR1 = (uint16_t)clamp((pwmValue < 0) ? -pwmValue : pwmValue, 0, 65535);

		position = (int16_t)TIM2->CNT;
		pwmValue = PIDcontrol(&motor2Control, position);
		HAL_GPIO_WritePin(M2_D_GPIO_Port, M2_D_Pin, (pwmValue < 0) ? GPIO_PIN_SET : GPIO_PIN_RESET);
		TIM4->CCR2 = (uint16_t)clamp((pwmValue < 0) ? -pwmValue : pwmValue, 0, 65535);

		position = (int16_t)TIM3->CNT;
		pwmValue = PIDcontrol(&motor3Control, position);
		HAL_GPIO_WritePin(M3_D_GPIO_Port, M3_D_Pin, (pwmValue < 0) ? GPIO_PIN_SET : GPIO_PIN_RESET);
		TIM4->CCR3 = (uint16_t)clamp((pwmValue < 0) ? -pwmValue : pwmValue, 0, 65535);

		timer+=1;
		if (timer == 50){
			timer = 0;
			enable_pid = 0;
			motor1Control.speed = 0;
			TIM4->CCR1 = 0;
			TIM4->CCR2 = 0;
			TIM4->CCR3 = 0;
			motor2Control.speed = 0;
			motor3Control.speed = 0;
			Thrower_Send(0);
		}
	}
}

/*

/* USER CODE END 0 */

/**
  * @brief  The application entry point.
  * @retval int
  */
int main(void)
{
  /* MCU Configuration--------------------------------------------------------*/

  /* Reset of all peripherals, Initializes the Flash interface and the Systick. */
  HAL_Init();

  /* Configure the system clock */
  SystemClock_Config();

  /* Initialize all configured peripherals */
  MX_GPIO_Init();
  MX_DMA_Init();
  MX_TIM2_Init();
  MX_TIM3_Init();
  MX_TIM1_Init();
  MX_TIM4_Init();
  MX_TIM8_Init();
  MX_TIM6_Init();
  MX_USB_Device_Init();
  MX_TIM17_Init();
  /* USER CODE BEGIN 2 */


  HAL_TIM_PWM_Start(&htim17, TIM_CHANNEL_1);
  HAL_TIM_Encoder_Start(&htim1, TIM_CHANNEL_1 | TIM_CHANNEL_2);
  HAL_TIM_Encoder_Start(&htim2, TIM_CHANNEL_1 | TIM_CHANNEL_2);
  HAL_TIM_Encoder_Start(&htim3, TIM_CHANNEL_1 | TIM_CHANNEL_2);
  HAL_TIM_PWM_Start(&htim4, TIM_CHANNEL_1);
  HAL_TIM_PWM_Start(&htim4, TIM_CHANNEL_2);
  HAL_TIM_PWM_Start(&htim4, TIM_CHANNEL_3);

  TIM17->CCR1 = 65535;
  HAL_Delay(100);
  TIM17->CCR1 = 61750;
  HAL_Delay(100);
  TIM17->CCR1 = 65535;
  TIM4->CCR1 = 0;
  TIM4->CCR2 = 0;
  TIM4->CCR3 = 0;

  Thrower_Send(0);

  HAL_TIM_Base_Start_IT(&htim6);

  /* USER CODE END 2 */

  /* Infinite loop */
  /* USER CODE BEGIN WHILE */
  while (1)
  {
    /* USER CODE END WHILE */

    /* USER CODE BEGIN 3 */

	  if (driverReset) {
		  driverReset = 0;
		  TIM17->CCR1 = 61750;
		  HAL_Delay(100);
	   	  TIM17->CCR1 = 65535;

	  }

	  if (isCommandReceived) { // (2)
	        isCommandReceived = 0;
	        motor1Control.speed = command.speed1;
	        motor2Control.speed = command.speed2;
	        motor3Control.speed = command.speed3;

	        Thrower_Send(command.throwerSpeed);
  	        timer = 0;
  	        enable_pid = 1;

	        feedback.speed1 = motor1Control.speed; // (4)
	        feedback.speed2 = motor2Control.speed;
	        feedback.speed3 = motor3Control.speed;

	        CDC_Transmit_FS(&feedback, sizeof(feedback)); // (5)
	      }
	    }

  /* USER CODE END 3 */
}

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
