ut-robotics/picr21-team-kobe/Kobe_Elektronics/KobeMotorTester/Core/Inc/main.h

#define LED_Pin GPIO_PIN_2
#define LED_GPIO_Port GPIOA
#define M1_D_Pin GPIO_PIN_3
#define M1_D_GPIO_Port GPIOB
#define M2_D_Pin GPIO_PIN_4
#define M2_D_GPIO_Port GPIOB
#define M3_D_Pin GPIO_PIN_5
#define M3_D_GPIO_Port GPIOB
