ut-robotics/picr21-team-kobe/(commit log)

no date camera enhancements
no date fixed thrower speed bug
    [robot_runner.py, thrower.py]
2021-09-16 Fixed some movement logic errors; Added logging comments for debugging
    [movement.py]
2021-09-16 Added code for motor tests
2021-09-17 Fixed closing of connection to serial port
    [movement.py]
2021-09-18 added serial communication, now just need to test if the sent command makes to motor move
2021-09-27 Added code for camera test
2021-09-27 Color and depth frame alignment
2021-10-04 potential camera fix
2021-10-14 made camera width and height constant throughout code
2021-10-19 minor fix for serial hopefully
    [serialcomms.py]
2021-10-28 Reworked websocket client and server
    [referee_client.py, referee_server.py]
2021-11-01 Put referee server process on thread
2021-11-07 minor code refactor and changed camera config
2021-11-07 added match case functionality?
2021-11-08 fine tuned omni motion and using switch cases
2021-11-10 Refactored and added threading? minor tuning of movement logic
2021-11-17 Add config.ini; Remove websocket_config.json; Fixed threading
2021-11-18 Fixed command handling and threading
2021-11-19 trying to add color sampler
2021-11-24 deleted threshold config values, refactored slightly, added duty cycle to distance mapping, added debug state for easier thrower speed calibratrion
2021-11-25 added better thresholding and calibrated thrower
2021-11-29 calibrated thrower, added acceleration
2021-12-02 added basket avoidance when too close
    [color_sampler.py, image_processor.py]
2021-12-02 calibrated thrower adn threshold
2021-12-06 Adapt CameraConfig.py to PEP8 guidelines
2021-12-06 Adapt camera.py to PEP8 guidelines; Fix typos
2021-12-09 changed calibration
2021-12-13 fixed line sequence checker
    [color_sampler.py, image_processor.py, robot_runner.py]
2021-12-16 fixed optimizing turning logic
    [color_sampler.py, image_processor.py, robot_runner.py]
2021-12-23 fixed sign speed calculation bug and wheel angles for new robot
    [movement.py, robot_runner.py, serialcomms.py]
2022-01-09 Firmware
    Working firmware with calibrated PI
2022-01-20 feat: wip robot avoidance
    [image_processor.py]
2022-01-20 fix: robot patrolling is functional now
    [image_processor.py, robot_runner.py]
2022-01-20 feat: add primitive obstacle avoidance
    [image_processor.py, robot_runner.py]
2022-01-20 fix: patrolling works properly now and basket bottom line is used for distancing
    [image_processor.py, robot_runner.py]
2022-01-20 Relocate ID change handling to client; Rework exception handling for ID input
    [referee_client.py, referee_server.py]
2022-01-21 fix: basic obstacle avoidance works now, motors use dshot now
    [image_processor.py, movement.py, robot_runner.py, thrower.py]
2022-01-22 feat: add closing instead of dilation, fix turn direction(maybe)
    [config_colors.py, image_processor.py, robot_runner.py]
2022-01-22 fix: add more accurate thrower calibration
    [robot_runner.py, thrower.py]
2022-01-22 bug: left side of obstacle avoidance only works
    [image_processor.py, robot_runner.py]
2022-01-22 fix: obstacle avoidance fully working
    [image_processor.py, robot_runner.py]
2022-01-22 Documentation
    Ducumentation without functionality description
    [BOM_PartType-Kobe_BasketballRobot.xlsx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]
2022-01-23 feat: obstacle avoidance now in patrolling state too
    [image_processor.py, movement.py, robot_runner.py]
2022-01-24 fix: patrol state switching fixed after merge
    [movement.py, robot_runner.py]
